andreashey/nucleo-devboard/Nucleo_devboard.kicad_pcb

## KiCad design Nucleo_devboard.kicad_pcb (2026-08-03)

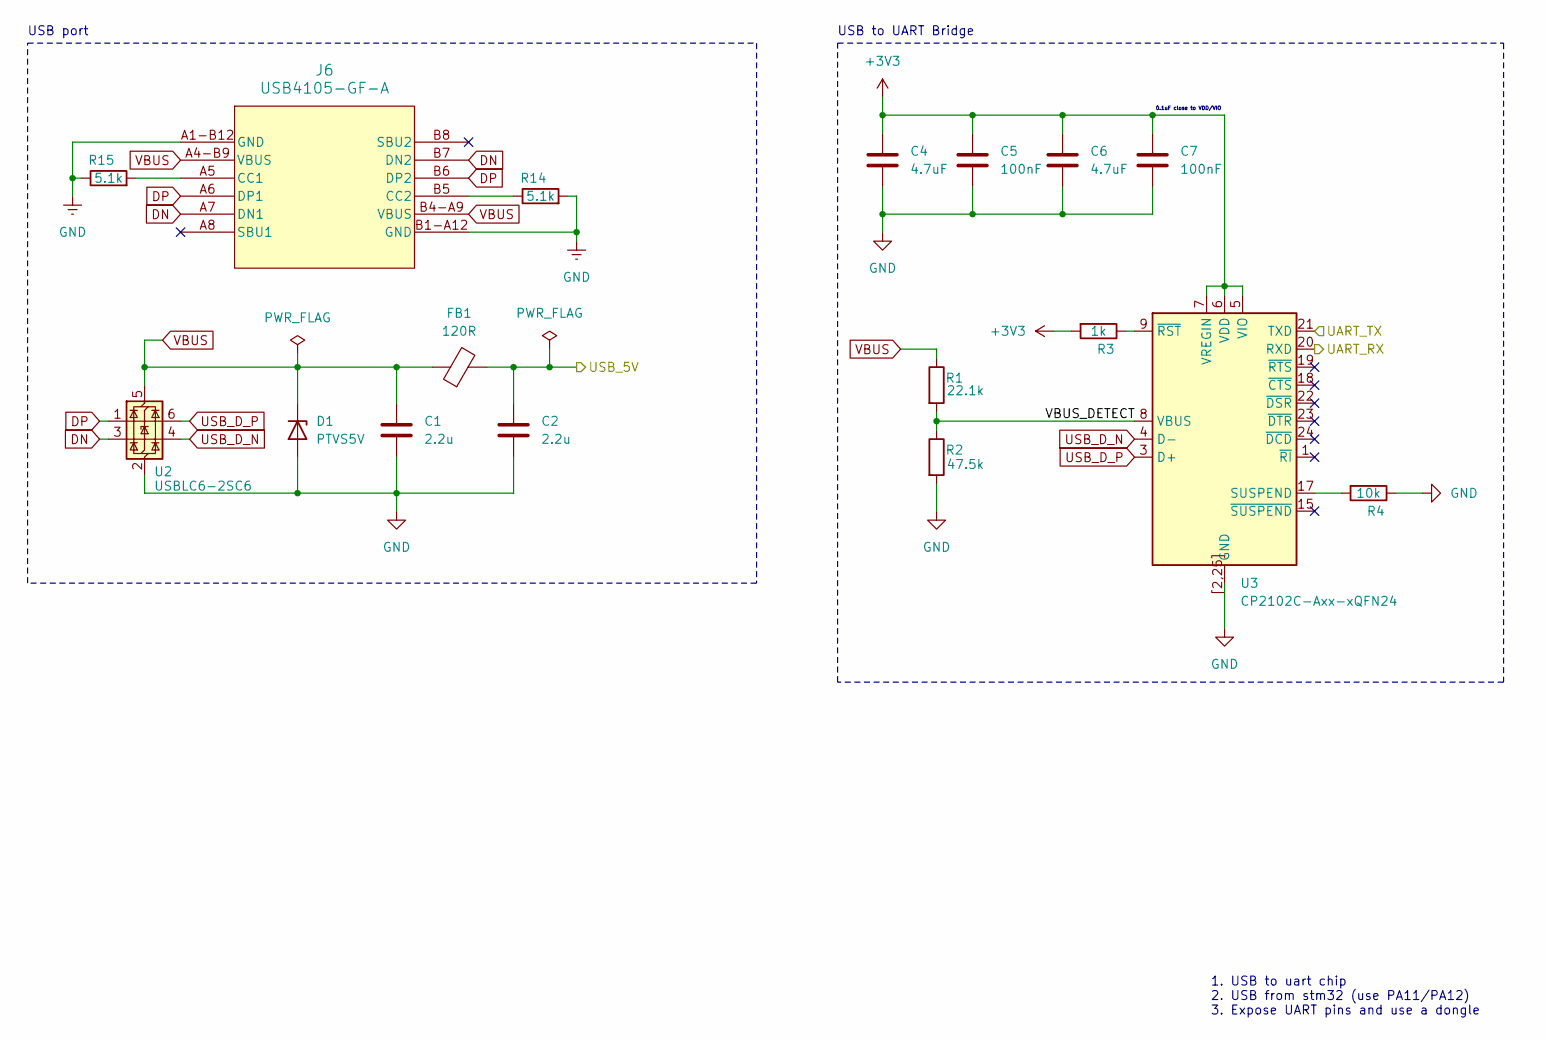
[picture p1: schematic usb.kicad_sch]

Parts:
C1, C2: 2.2u; C_0805_2012Metric
C4, C6: 4.7uF; C_0805_2012Metric
C5, C7: 100nF; C_0603_1608Metric
D1: PTVS5V; D_SOD-123
FB1: 120R; L_0805_2012Metric
J6: USB4105-GF-A; USB4105_GCT
R1: 22.1k; R_0603_1608Metric
R2: 47.5k; R_0603_1608Metric
R3: 1k; R_0805_2012Metric
R4: 10k; R_0805_2012Metric
R14, R15: 5.1k; R_0603_1608Metric
U2: USBLC6-2SC6; SOT-23-6
U3: CP2102C-Axx-xQFN24; WQFN-24-1EP_4x4mm_P0.5mm_EP2.45x2.45mm

Connections:
+3V3: C4.1, C5.1, C6.1, C7.1, R3.2, U3.5 (VIO), U3.6 (VDD), U3.7 (VREGIN); also elsewhere on the board
/MCU 1/USART3_RX: U3.20 (RXD); also elsewhere on the board
/MCU 1/USART3_TX: U3.21 (TXD); also elsewhere on the board
/Power/USB_5V: C2.1, FB1.2; also elsewhere on the board
/USB/VBUS_DETECT: R1.2, R2.1, U3.8 (VBUS)
DN: J6.A7 (DN1), J6.B7 (DN2), U2.3 (I/O2)
DP: J6.A6 (DP1), J6.B6 (DP2), U2.1 (I/O1)
GND: C1.2, C2.2, C4.2, C5.2, C6.2, C7.2, D1.2 (A), J6.A1-B12 (GND), J6.B1-A12 (GND), R2.2, R4.1, R14.2, R15.1, U2.2 (GND), U3.2 (GND), U3.25 (GND), U3.[2,25] (GND); also elsewhere on the board
unnamed: J6.A5 (CC1), R15.2
unnamed: J6.B5 (CC2), R14.1
unnamed: R4.2, U3.17 (SUSPEND)
unnamed: R3.1, U3.9 (~RST)
USB_D_N: U2.4 (I/O2), U3.4 (D-)
USB_D_P: U2.6 (I/O1), U3.3 (D+)
VBUS: C1.1, D1.1 (K), FB1.1, J6.A4-B9 (VBUS), J6.B4-A9 (VBUS), R1.1, U2.5 (VBUS)

Notes on the sheet:
1. USB to uart chip 2. USB from stm32 (use PA11/PA12) 3. Expose UART pins and use a dongle
USB to UART Bridge
USB port
0.1uF close to VDD/VIO

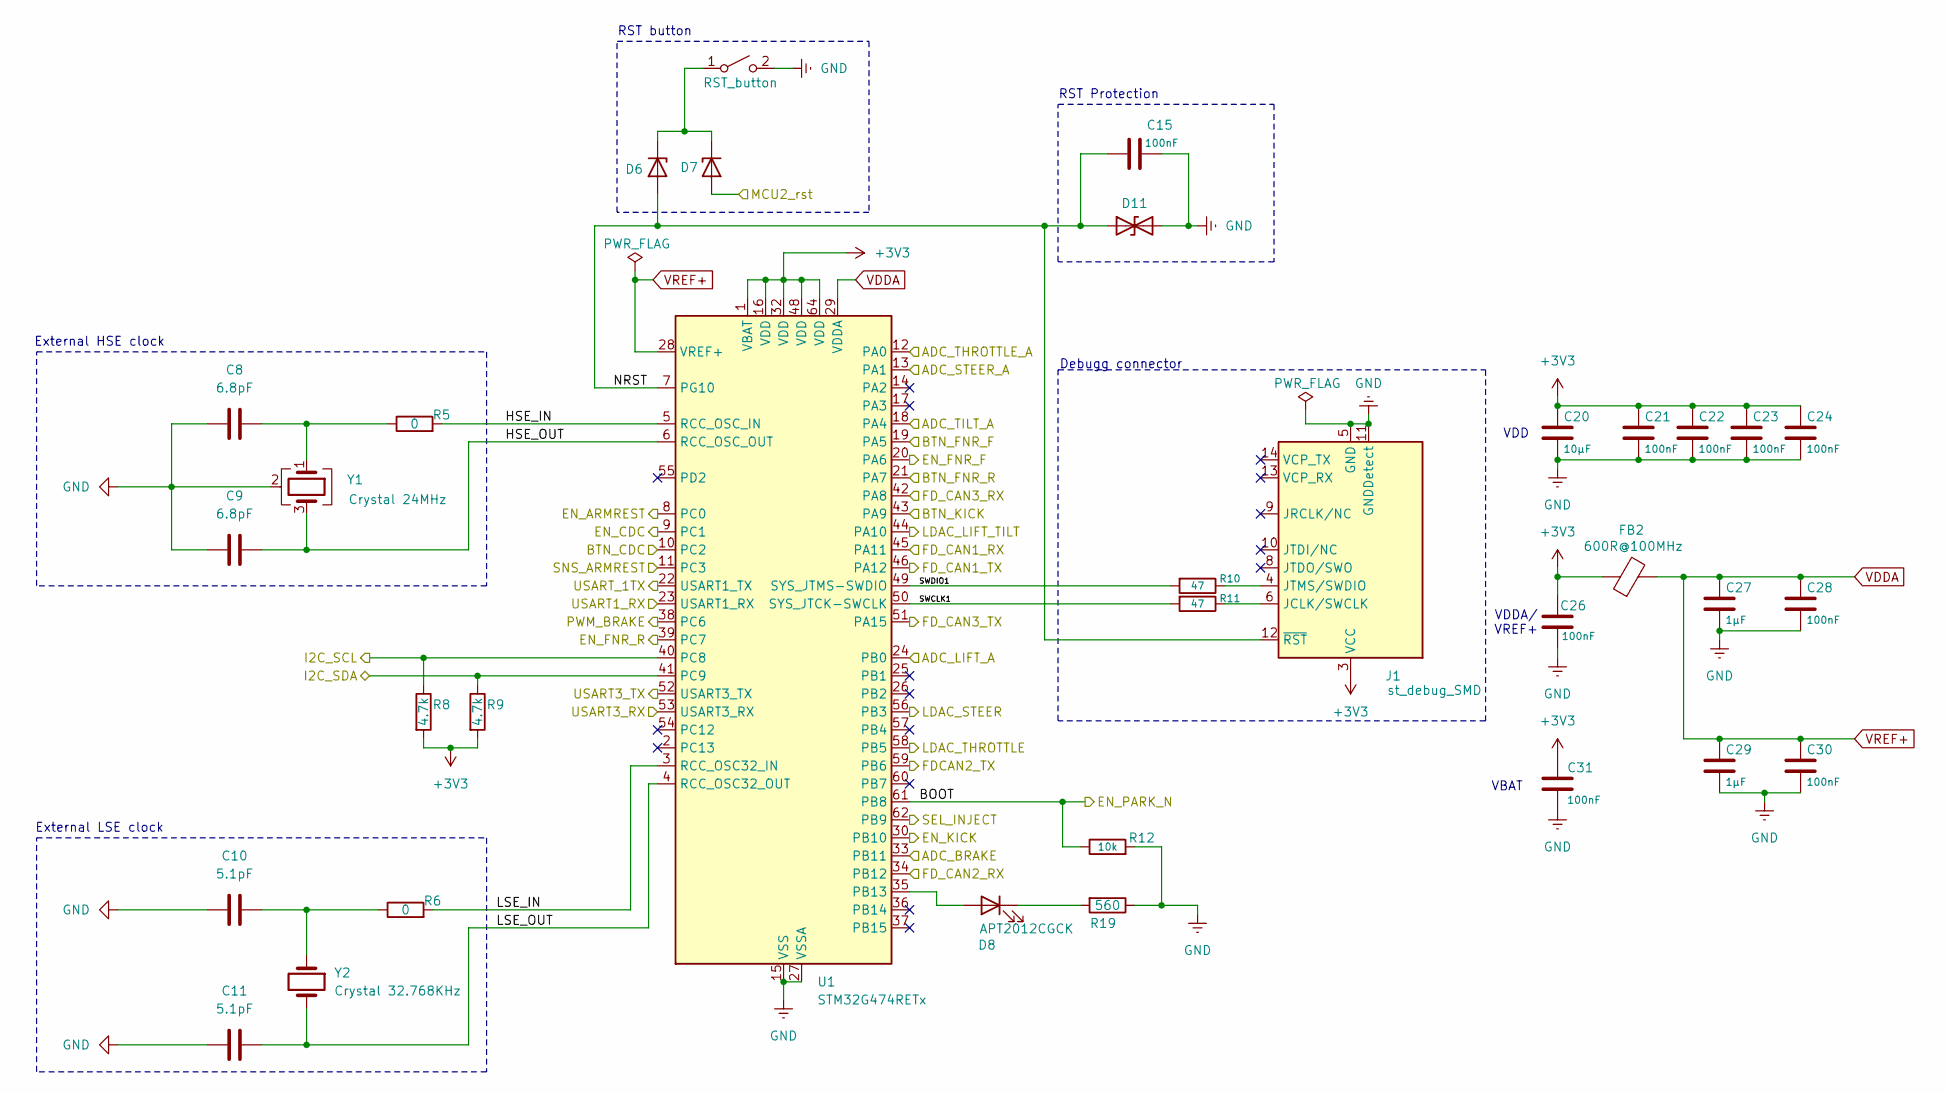
[picture p2: schematic mcu.kicad_sch]

Parts:
C8, C9: 6.8pF; C_0402_1005Metric
C10, C11: 5.1pF; C_0402_1005Metric
C15, C21, C22, C23, C24, C26, C28, C30, C31: 100nF; C_0603_1608Metric
C20: 10μF; C_1206_3216Metric
C27, C29: 1μF; C_0603_1608Metric
D6, D7: BAT60A; D_SOD-323
D8: APT2012CGCK; LED_0805_2012Metric
D11: STS321033B401; D_SOD-323
FB2: 600R@100MHz; L_0603_1608Metric
J1: st_debug_SMD; PinHeader_2x07_P1.27mm_Vertical_SMD
R5, R6: 0; R_0603_1608Metric
R8, R9: 4.7k; R_0805_2012Metric
R10, R11: 47; R_0603_1608Metric
R12: 10k; R_0805_2012Metric
R19: 560; R_0805_2012Metric
RESET1: RST_button; SW_TH_Tactile_Omron_B3F-100x
U1: STM32G474RETx; LQFP-64_10x10mm_P0.5mm
Y1: Crystal 24MHz; Crystal_SMD_2016-4Pin_2.0x1.6mm
Y2: Crystal 32.768KHz; Crystal_SMD_3215-2Pin_3.2x1.5mm

Connections:
+3V3: C20.1, C21.1, C22.1, C23.1, C24.1, C26.1, C31.1, FB2.1, J1.3 (VCC), R8.2, R9.2, U1.1 (VBAT), U1.16 (VDD), U1.32 (VDD), U1.48 (VDD), U1.64 (VDD); also elsewhere on the board
/MCU 1/ADC_BRAKE: U1.33 (PB11); also elsewhere on the board
/MCU 1/ADC_LIFT_A: U1.24 (PB0); also elsewhere on the board
/MCU 1/ADC_STEER_A: U1.13 (PA1); also elsewhere on the board
/MCU 1/ADC_THROTTLE_A: U1.12 (PA0); also elsewhere on the board
/MCU 1/ADC_TILT_A: U1.18 (PA4); also elsewhere on the board
/MCU 1/BOOT: R12.1, U1.61 (PB8); also elsewhere on the board
/MCU 1/BTN_CDC: U1.10 (PC2); also elsewhere on the board
/MCU 1/BTN_FNR_F: U1.19 (PA5); also elsewhere on the board
/MCU 1/BTN_FNR_R: U1.21 (PA7); also elsewhere on the board
/MCU 1/BTN_KICK: U1.43 (PA9); also elsewhere on the board
/MCU 1/EN_ARMREST: U1.8 (PC0); also elsewhere on the board
/MCU 1/EN_CDC: U1.9 (PC1); also elsewhere on the board
/MCU 1/EN_FNR_F: U1.20 (PA6); also elsewhere on the board
/MCU 1/EN_FNR_R: U1.39 (PC7); also elsewhere on the board
/MCU 1/EN_KICK: U1.30 (PB10); also elsewhere on the board
/MCU 1/FDCAN2_TX: U1.59 (PB6); also elsewhere on the board
/MCU 1/FD_CAN1_RX: U1.45 (PA11); also elsewhere on the board
/MCU 1/FD_CAN1_TX: U1.46 (PA12); also elsewhere on the board
/MCU 1/FD_CAN2_RX: U1.34 (PB12); also elsewhere on the board
/MCU 1/FD_CAN3_RX: U1.42 (PA8); also elsewhere on the board
/MCU 1/FD_CAN3_TX: U1.51 (PA15); also elsewhere on the board
/MCU 1/HSE_IN: R5.2, U1.5 (RCC_OSC_IN)
/MCU 1/HSE_OUT: C9.2, U1.6 (RCC_OSC_OUT), Y1.3
/MCU 1/I2C_SCL: R8.1, U1.40 (PC8); also elsewhere on the board
/MCU 1/I2C_SDA: R9.1, U1.41 (PC9); also elsewhere on the board
/MCU 1/LDAC_LIFT_TILT: U1.44 (PA10); also elsewhere on the board
/MCU 1/LDAC_STEER: U1.56 (PB3); also elsewhere on the board
/MCU 1/LDAC_THROTTLE: U1.58 (PB5); also elsewhere on the board
/MCU 1/LSE_IN: R6.2, U1.3 (RCC_OSC32_IN)
/MCU 1/LSE_OUT: C11.2, U1.4 (RCC_OSC32_OUT), Y2.2
/MCU 1/NRST: C15.1, D6.2 (A), D11.1 (A1), J1.12 (~RST), U1.7 (PG10)
/MCU 1/PWM_BRAKE: U1.38 (PC6); also elsewhere on the board
/MCU 1/SEL_INJECT: U1.62 (PB9); also elsewhere on the board
/MCU 1/SNS_ARMREST: U1.11 (PC3); also elsewhere on the board
/MCU 1/SWCLK1: R11.2, U1.50 (SYS_JTCK-SWCLK)
/MCU 1/SWDIO1: R10.2, U1.49 (SYS_JTMS-SWDIO)
/MCU 1/USART1_RX: U1.23 (USART1_RX); also elsewhere on the board
/MCU 1/USART3_RX: U1.53 (USART3_RX); also elsewhere on the board
/MCU 1/USART3_TX: U1.52 (USART3_TX); also elsewhere on the board
/MCU 1/USART_1TX: U1.22 (USART1_TX); also elsewhere on the board
/MCU 2/NRST: D7.2 (A); also elsewhere on the board
GND: C8.1, C9.1, C10.1, C11.1, C15.2, C20.2, C21.2, C22.2, C23.2, C24.2, C26.2, C27.2, C28.2, C29.2, C30.2, C31.2, D11.2 (A2), J1.5 (GND), J1.7 (GND), J1.11 (GNDDetect), R12.2, R19.1, RESET1.2 (B), U1.15 (VSS), U1.27 (VSSA), U1.31 (VSS), U1.47 (VSS), U1.63 (VSS), Y1.2 (G), Y1.4 (G); also elsewhere on the board
unnamed: C8.2, R5.1, Y1.1
unnamed: C10.2, R6.1, Y2.1
unnamed: D6.1 (K), D7.1 (K), RESET1.1 (A)
unnamed: D8.2 (A), U1.35 (PB13)
unnamed: D8.1 (K), R19.2
unnamed: J1.6 (JCLK/SWCLK), R11.1
unnamed: J1.4 (JTMS/SWDIO), R10.1
VDDA: C27.1, C28.1, C29.1, C30.1, FB2.2, U1.28 (VREF+), U1.29 (VDDA)

Notes on the sheet:
External LSE clock
VDDA/ VREF+
VBAT
VDD
RST Protection
RST button
External HSE clock
Debugg connector

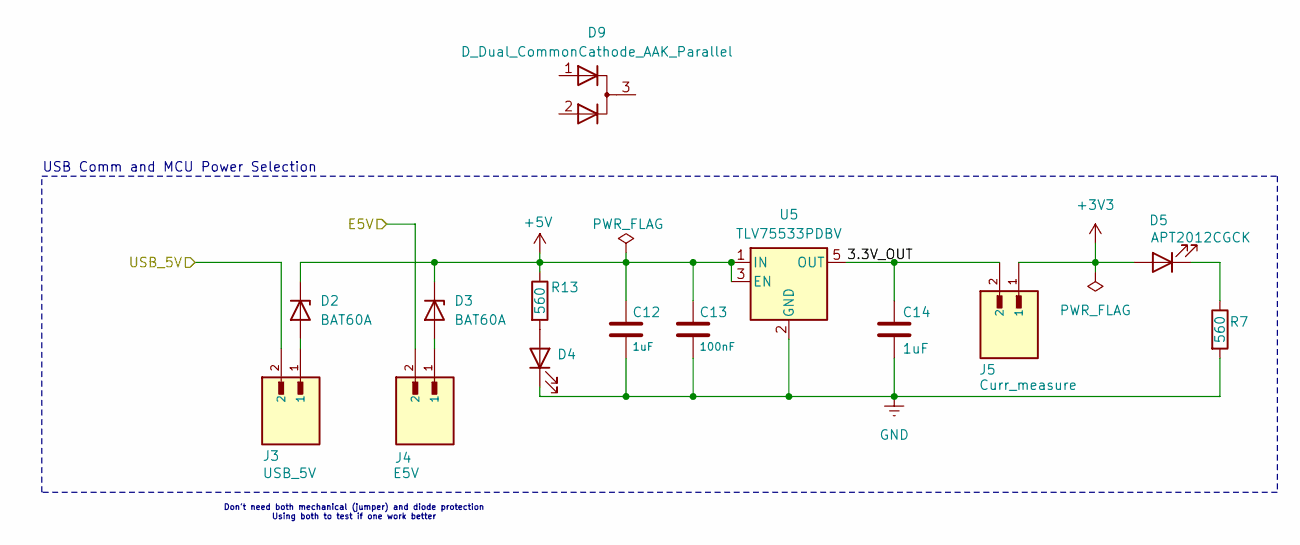
[picture p3: schematic Power_sel.kicad_sch]

Parts:
C12, C14: 1uF; C_0603_1608Metric
C13: 100nF; C_0603_1608Metric
D2, D3: BAT60A; D_SOD-323
D4, D5: APT2012CGCK; LED_0805_2012Metric
D9: D_Dual_CommonCathode_AAK_Parallel; SOT-23
J3: USB_5V; jumper_header; PARTREV 14
J4: E5V; jumper_header; PARTREV 14
J5: Curr_measure; jumper_header; PARTREV 14
R7, R13: 560; R_0805_2012Metric
U5: TLV75533PDBV; SOT-23-5

Connections:
+3V3: D5.2 (A), J5.1; also elsewhere on the board
+5V: C12.1, C13.1, D2.1 (K), D3.1 (K), R13.1, U5.1 (IN), U5.3 (EN); also elsewhere on the board
/Morpho connector/E5V: J4.2; also elsewhere on the board
/Power/3.3V_OUT: C14.1, J5.2, U5.5 (OUT)
/Power/USB_5V: J3.2; also elsewhere on the board
GND: C12.2, C13.2, C14.2, D4.1 (K), R7.2, U5.2 (GND); also elsewhere on the board
unnamed: D2.2 (A), J3.1
unnamed: D3.2 (A), J4.1
unnamed: D4.2 (A), R13.2
unnamed: D5.1 (K), R7.1

Notes on the sheet:
Don't need both mechanical (jumper) and diode protection Using both to test if one work better
USB Comm and MCU Power Selection

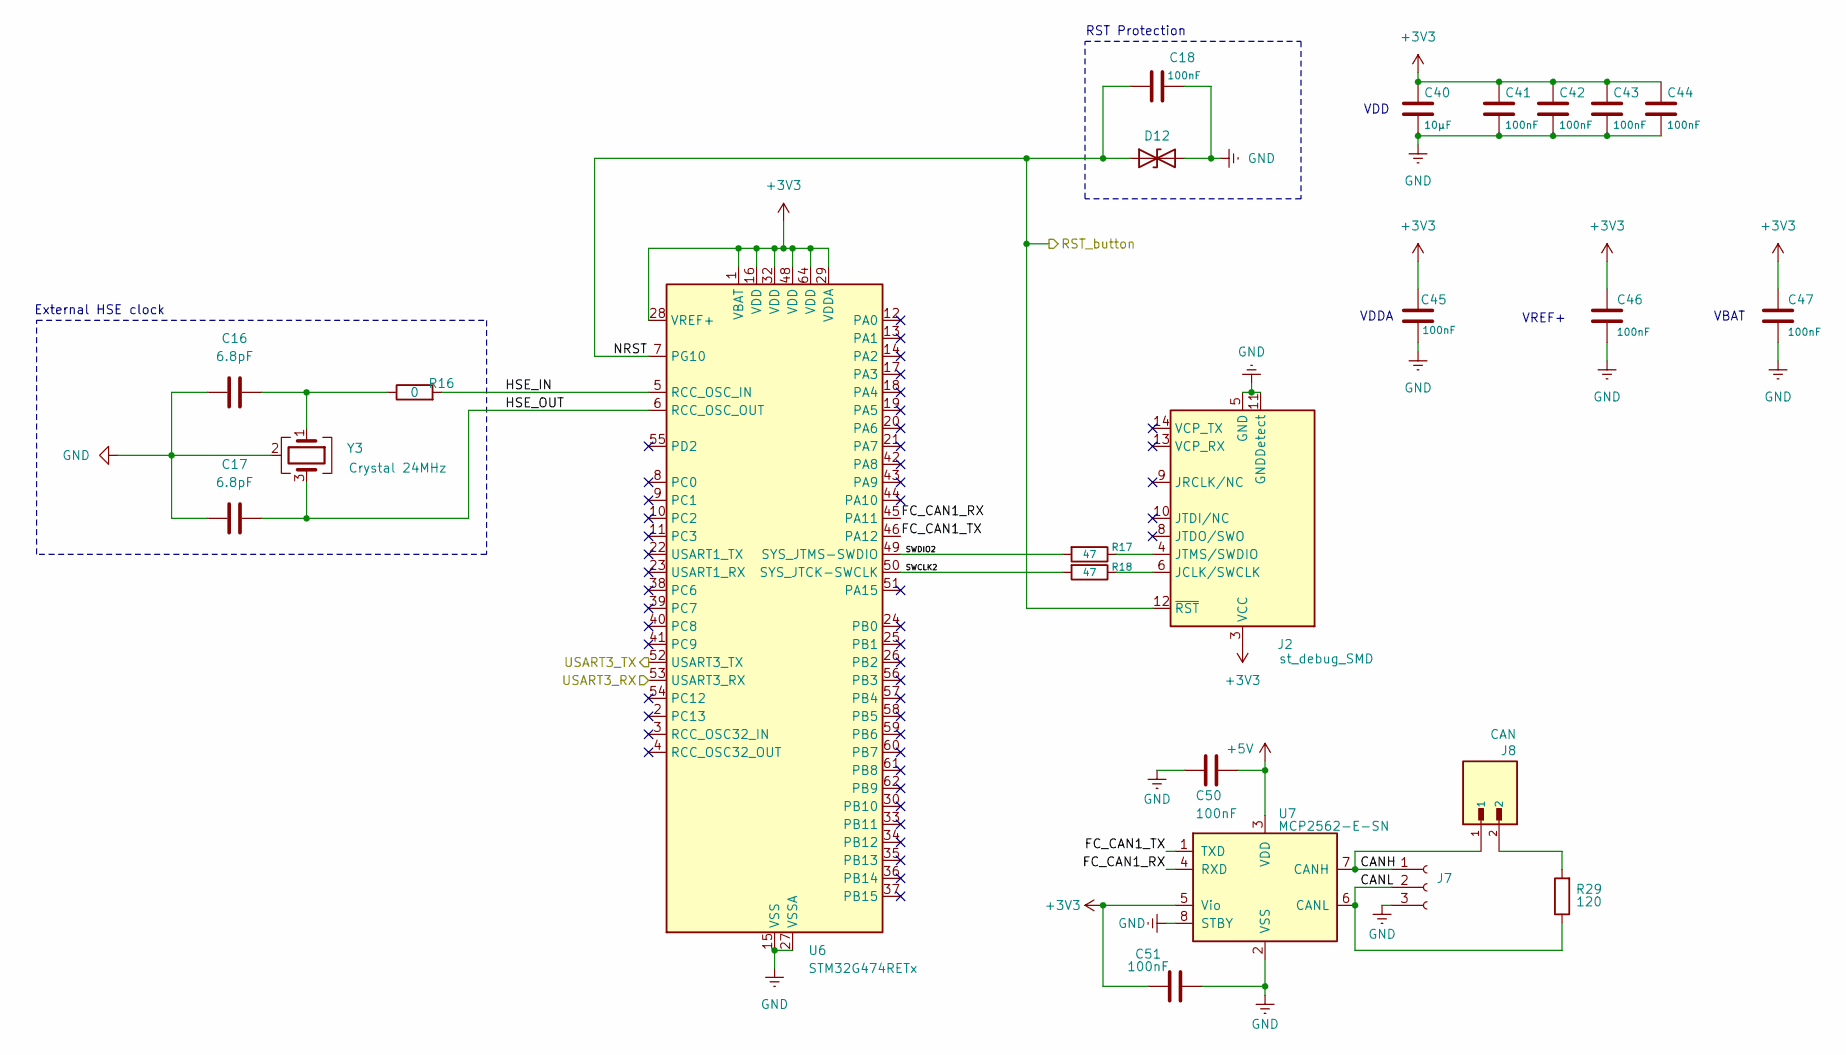
[picture p4: schematic mcu_2.kicad_sch]

Parts:
C16, C17: 6.8pF; C_0402_1005Metric
C18, C41, C42, C43, C44, C45, C46, C47, C50, C51: 100nF; C_0603_1608Metric
C40: 10μF; C_1206_3216Metric
D12: STS321033B401; D_SOD-323
J2: st_debug_SMD; PinHeader_2x07_P1.27mm_Vertical_SMD
J7: Conn_01x03_Socket; DF3-3P-2DSA
J8: CAN; jumper_header; PARTREV 14
R16: 0; R_0603_1608Metric
R17, R18: 47; R_0603_1608Metric
R29: 120; R_0805_2012Metric
U6: STM32G474RETx; LQFP-64_10x10mm_P0.5mm
U7: MCP2562-E-SN; SOIC-8_3.9x4.9mm_P1.27mm
Y3: Crystal 24MHz; Crystal_SMD_2016-4Pin_2.0x1.6mm

Connections:
+3V3: C40.1, C41.1, C42.1, C43.1, C44.1, C45.1, C46.1, C47.1, C51.1, J2.3 (VCC), U6.1 (VBAT), U6.16 (VDD), U6.28 (VREF+), U6.29 (VDDA), U6.32 (VDD), U6.48 (VDD), U6.64 (VDD), U7.5 (Vio); also elsewhere on the board
+5V: C50.2, U7.3 (VDD); also elsewhere on the board
/MCU 1/USART1_RX: U6.52 (USART3_TX); also elsewhere on the board
/MCU 1/USART_1TX: U6.53 (USART3_RX); also elsewhere on the board
/MCU 2/CANH: J7.1, J8.1, U7.7 (CANH)
/MCU 2/CANL: J7.2, R29.1, U7.6 (CANL)
/MCU 2/FC_CAN1_RX: U6.45 (PA11), U7.4 (RXD)
/MCU 2/FC_CAN1_TX: U6.46 (PA12), U7.1 (TXD)
/MCU 2/HSE_IN: R16.2, U6.5 (RCC_OSC_IN)
/MCU 2/HSE_OUT: C17.2, U6.6 (RCC_OSC_OUT), Y3.3
/MCU 2/NRST: C18.1, D12.1 (A1), J2.12 (~RST), U6.7 (PG10); also elsewhere on the board
/MCU 2/SWCLK2: R18.2, U6.50 (SYS_JTCK-SWCLK)
/MCU 2/SWDIO2: R17.2, U6.49 (SYS_JTMS-SWDIO)
GND: C16.1, C17.1, C18.2, C40.2, C41.2, C42.2, C43.2, C44.2, C45.2, C46.2, C47.2, C50.1, C51.2, D12.2 (A2), J2.5 (GND), J2.7 (GND), J2.11 (GNDDetect), J7.3, U6.15 (VSS), U6.27 (VSSA), U6.31 (VSS), U6.47 (VSS), U6.63 (VSS), U7.2 (VSS), U7.8 (STBY), Y3.2 (G), Y3.4 (G); also elsewhere on the board
unnamed: C16.2, R16.1, Y3.1
unnamed: J2.6 (JCLK/SWCLK), R18.1
unnamed: J2.4 (JTMS/SWDIO), R17.1
unnamed: J8.2, R29.2

Notes on the sheet:
VREF+
External HSE clock
RST Protection
VBAT
VDD
VDDA

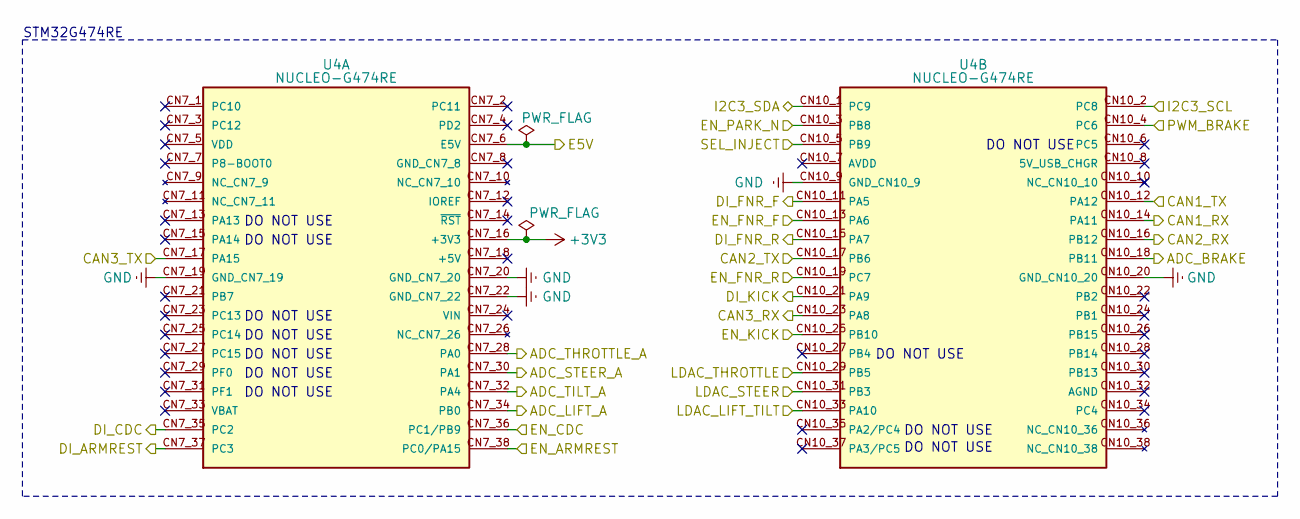
[picture p5: schematic Morpho.kicad_sch]

Parts:
U4: NUCLEO-G474RE; MODULE_NUCLEO-G474RE; PARTREV 17

Connections:
+3V3: U4.CN7_16 (+3V3); also elsewhere on the board
/MCU 1/ADC_BRAKE: U4.CN10_18 (PB11); also elsewhere on the board
/MCU 1/ADC_LIFT_A: U4.CN7_34 (PB0); also elsewhere on the board
/MCU 1/ADC_STEER_A: U4.CN7_30 (PA1); also elsewhere on the board
/MCU 1/ADC_THROTTLE_A: U4.CN7_28 (PA0); also elsewhere on the board
/MCU 1/ADC_TILT_A: U4.CN7_32 (PA4); also elsewhere on the board
/MCU 1/BOOT: U4.CN10_3 (PB8); also elsewhere on the board
/MCU 1/BTN_CDC: U4.CN7_35 (PC2); also elsewhere on the board
/MCU 1/BTN_FNR_F: U4.CN10_11 (PA5); also elsewhere on the board
/MCU 1/BTN_FNR_R: U4.CN10_15 (PA7); also elsewhere on the board
/MCU 1/BTN_KICK: U4.CN10_21 (PA9); also elsewhere on the board
/MCU 1/EN_ARMREST: U4.CN7_38 (PC0/PA15); also elsewhere on the board
/MCU 1/EN_CDC: U4.CN7_36 (PC1/PB9); also elsewhere on the board
/MCU 1/EN_FNR_F: U4.CN10_13 (PA6); also elsewhere on the board
/MCU 1/EN_FNR_R: U4.CN10_19 (PC7); also elsewhere on the board
/MCU 1/EN_KICK: U4.CN10_25 (PB10); also elsewhere on the board
/MCU 1/FDCAN2_TX: U4.CN10_16 (PB12); also elsewhere on the board
/MCU 1/FD_CAN1_RX: U4.CN10_14 (PA11); also elsewhere on the board
/MCU 1/FD_CAN1_TX: U4.CN10_12 (PA12); also elsewhere on the board
/MCU 1/FD_CAN2_RX: U4.CN10_17 (PB6); also elsewhere on the board
/MCU 1/FD_CAN3_RX: U4.CN10_23 (PA8); also elsewhere on the board
/MCU 1/FD_CAN3_TX: U4.CN7_17 (PA15); also elsewhere on the board
/MCU 1/I2C_SCL: U4.CN10_2 (PC8); also elsewhere on the board
/MCU 1/I2C_SDA: U4.CN10_1 (PC9); also elsewhere on the board
/MCU 1/LDAC_LIFT_TILT: U4.CN10_33 (PA10); also elsewhere on the board
/MCU 1/LDAC_STEER: U4.CN10_31 (PB3); also elsewhere on the board
/MCU 1/LDAC_THROTTLE: U4.CN10_29 (PB5); also elsewhere on the board
/MCU 1/PWM_BRAKE: U4.CN10_4 (PC6); also elsewhere on the board
/MCU 1/SEL_INJECT: U4.CN10_5 (PB9); also elsewhere on the board
/MCU 1/SNS_ARMREST: U4.CN7_37 (PC3); also elsewhere on the board
/Morpho connector/E5V: U4.CN7_6 (E5V); also elsewhere on the board
GND: U4.CN7_19 (GND_CN7_19), U4.CN7_20 (GND_CN7_20), U4.CN7_22 (GND_CN7_22), U4.CN10_9 (GND_CN10_9), U4.CN10_20 (GND_CN10_20); also elsewhere on the board

Notes on the sheet:
DO NOT USE
STM32G474RE

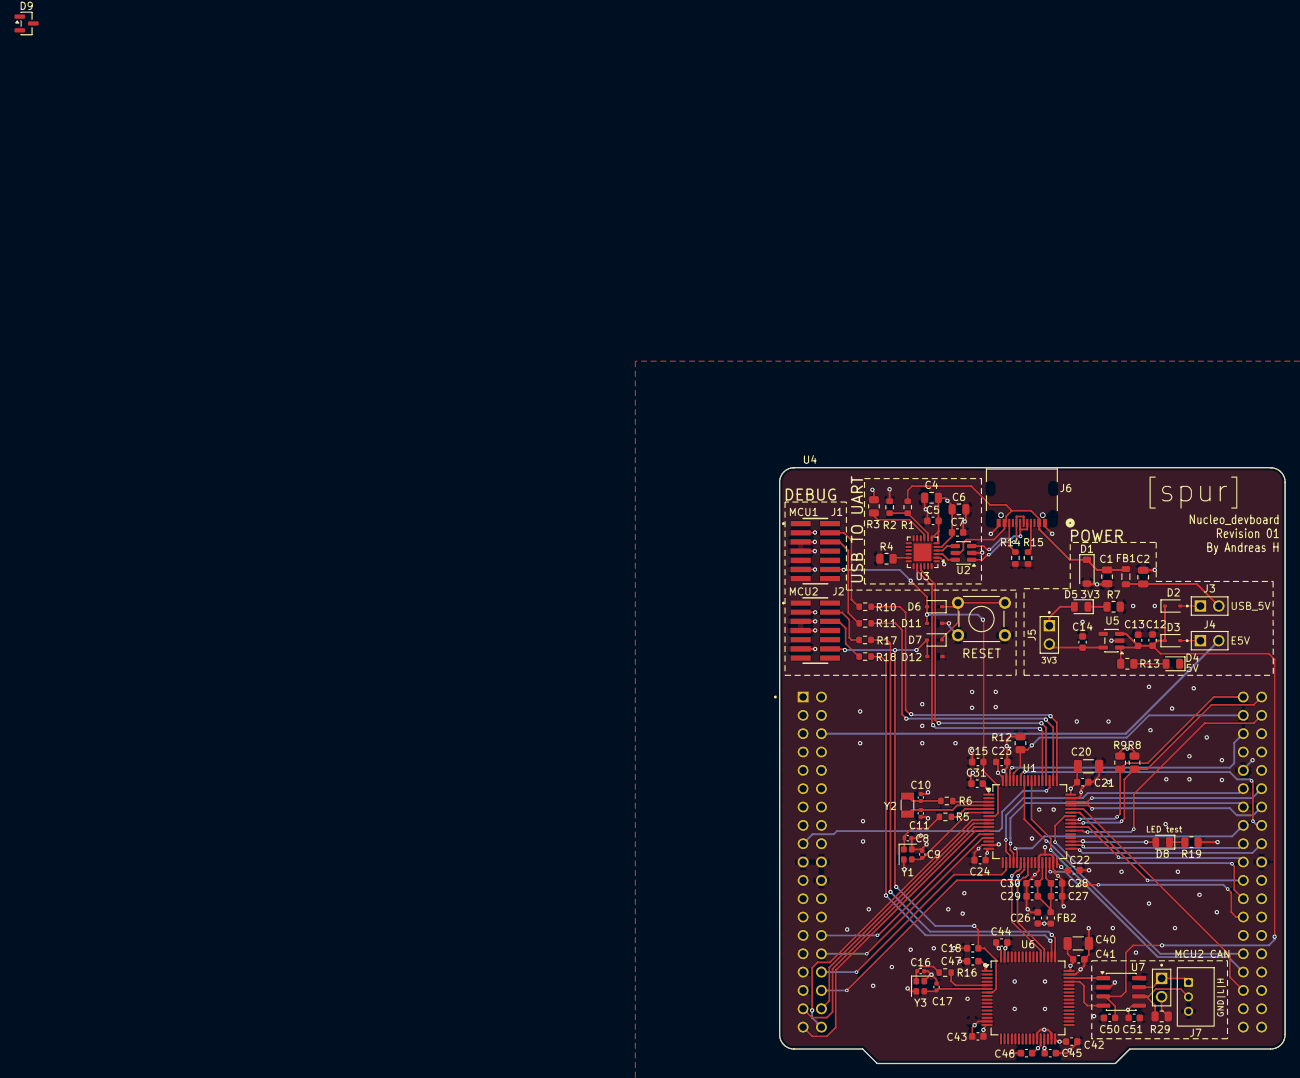
[picture p6: board Nucleo_devboard.kicad_pcb from above]

Board: 4 copper layers, 70.0 x 82.5 mm, 90 parts (0 on the bottom side), 81 nets.
