andreashey/nucleo-devboard/(commit log)

2026-07-08 Added nucleo devboard project/schematics
    [.kicad_sch, Morpho.kicad_sch, Nucleo_devboard.kicad_sch, mcu.kicad_sch, power.kicad_sch, usb.kicad_sch]
2026-07-16 Added finishing thouches to brake sense pcb Finished main schematic layout and added chosen component footprints Placed components in layout and started tracing
    [Morpho.kicad_sch, Nucleo_devboard.kicad_pcb, Nucleo_devboard.kicad_sch, mcu.kicad_sch, usb.kicad_sch]
2026-07-18 Added Current reading for INA228 Started rev 02 on brake sense
    [Nucleo_devboard.kicad_pcb, mcu.kicad_sch]
2026-07-21 added rev04_mcu1/2.h revised brake sense board Added logic for 2 MCUs on nucleo board
    [Nucleo_devboard.kicad_pcb, Nucleo_devboard.kicad_sch, Power_sel.kicad_sch, mcu.kicad_sch, mcu_2.kicad_sch, untitled.kicad_sch, usb.kicad_sch]
2026-07-21 Generated scaffold for mcu2 finished brake sense rev2 finished adding second chip to nucleo devboard
    [Morpho.kicad_sch, Nucleo_devboard.kicad_pcb, Nucleo_devboard.kicad_sch, Power_sel.kicad_sch, mcu.kicad_sch, mcu_2.kicad_sch, usb.kicad_sch]
2026-07-22 Finished last thouches on brake sense and nucleo pcb (Ordered pcbs)
    [Nucleo_devboard-B_Mask.gbr, Nucleo_devboard-B_Paste.gbr, Nucleo_devboard-B_Signal.gbr, Nucleo_devboard-B_Silkscreen.gbr, Nucleo_devboard-Edge_Cuts.gbr, Nucleo_devboard-F_Mask.gbr, Nucleo_devboard-F_Paste.gbr, Nucleo_devboard-F_Silkscreen.gbr]
2026-07-23 volvo_h2 revision Revised switch regulator layout/components Changed brake circuit to use current sense amplifier Defined nets and nettclass constraints. Revises trace layout to fit new constraints.
    [Nucleo_devboard.kicad_pcb, Power_sel.kicad_sch, mcu_2.kicad_sch]
2026-07-24 Split nucleo project folder from tinynav
    [Nucleo_devboard.kicad_pcb]
2026-08-03 Commit before reference renaming
    [Nucleo_devboard.csv, Nucleo_devboard.kicad_pcb, Power_sel.kicad_sch]
2026-08-06 Kicad changes
